sensint/Servo_Haptics/hardware/renders_images/hs2-render-1.png

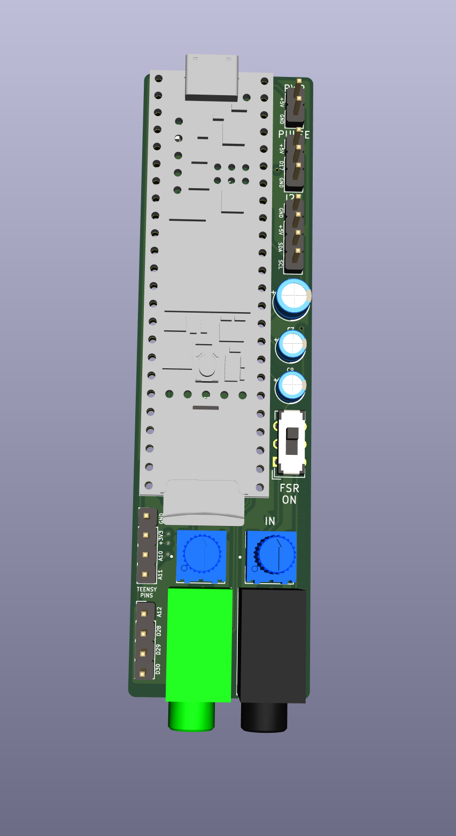
hardware/renders_images/hs2-render-1.png
