sensint/Servo_Haptics/hardware/renders_images/hs2-render-2.png

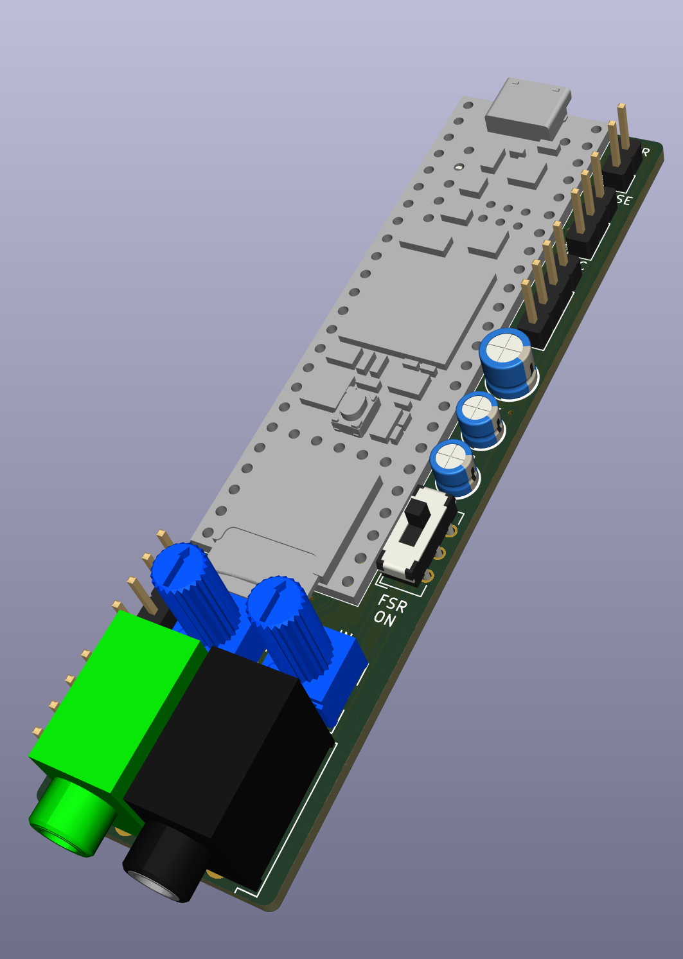
hardware/renders_images/hs2-render-2.png
