sensint/Servo_Haptics/hardware/renders_images/hs3-PCB.png

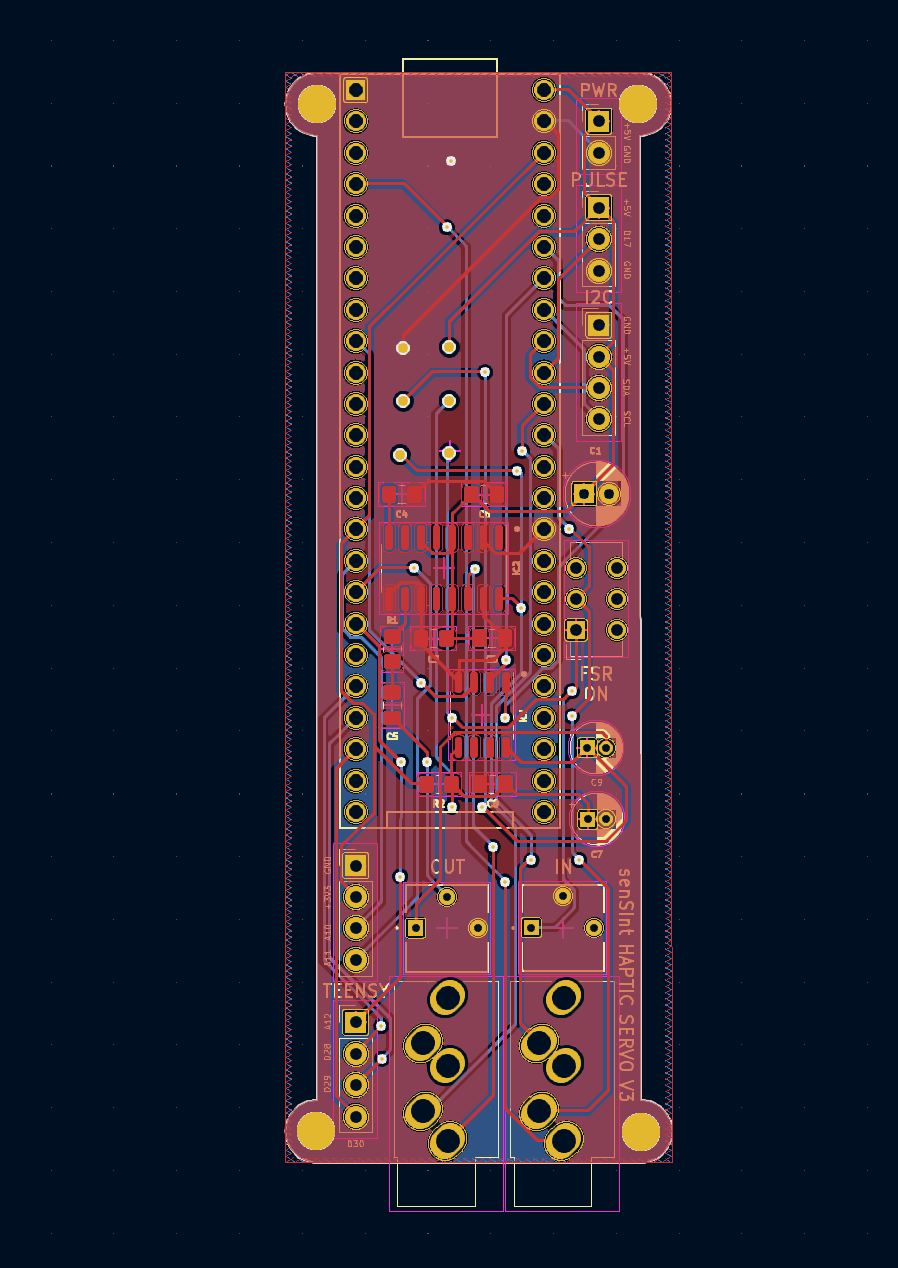
hardware/renders_images/hs3-PCB.png
