sensint/Servo_Haptics/hardware/renders_images/hs3-render-4.png

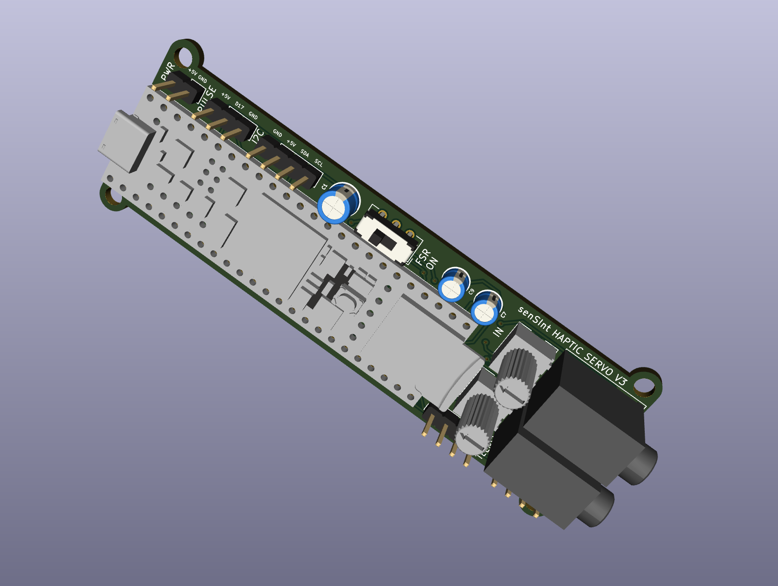
hardware/renders_images/hs3-render-4.png
