sensint/Servo_Haptics/hardware/Haptic_Servo_V3_BOM.xlsx

Haptic Servo
Teensy Shield BOM
Individual Components:
Reference(s) | Count | Value | LibPart | Footprint | Package | Product | Link
J4 | 1 |  | Connector:AudioJack3 | Connector_Audio:Jack_3.5mm_CUI_SJ1-3535NG_Horizontal | THT Tray | CUI Devices SJ1-3535NG-BE | https://www.digikey.de/de/products/detail/cui-devices/SJ1-3535NG-BE/2295992
J5 | 1 |  | Connector:AudioJack3 | Connector_Audio:Jack_3.5mm_CUI_SJ1-3535NG_Horizontal | THT Tray | CUI Devices SJ1-3535NG-PI | https://www.digikey.de/de/products/detail/cui-devices/SJ1-3535NG-PI/2295994
C4, 8 | 2 | 0.1 uF | Device:C | Capacitor_SMD:C_0805_2012Metric_Pad1.18x1.45mm_HandSolder | 805 | Kyocera AVX 08055C104KAT2A | https://www.digikey.de/en/products/detail/kyocera-avx/08055C104KAT2A/563505
C2, C3, C6 | 3 | 1 uF | Device:C | Capacitor_SMD:C_0805_2012Metric_Pad1.18x1.45mm_HandSolder | 805 | Kyocera AVX 08055C105KAT2A | https://www.digikey.de/en/products/detail/kyocera-avx/08055C105KAT2A/3081236
C5 | 1 | 0.47 uF | Device:C | Capacitor_SMD:C_0805_2012Metric_Pad1.18x1.45mm_HandSolder | 805 | Kyocera AVX 08055C474KAT2A | https://www.digikey.de/en/products/detail/kyocera-avx/08055C474KAT2A/1603015
C7, C9 | 2 | 47 uF | Device:C_Polarized_US | Capacitor_THT:CP_Radial_D4.0mm_P1.50mm | THT Bulk - 4mm dia, 1.5mm ls | Panasonic ECE-A0JKA470 | https://www.digikey.de/en/products/detail/panasonic-electronic-components/ECE-A0JKA470/6909
C1 | 1 | 470 uF | Device:C_Polarized_US | Capacitor_THT:CP_Radial_D5.0mm_P2.0mm | THT Bulk - 5mm dia, 2mm ls | Nichicon RF80E471MDN1JT | https://www.digikey.de/en/products/detail/nichicon/RF80E471MDN1JT/4991402
R2 | 1 | 10 ohm | Device:R | Resistor_SMD:R_0805_2012Metric_Pad1.20x1.40mm_HandSolder | 805 | Panasonic ERJ-6GEYJ100V | https://www.digikey.de/en/products/detail/panasonic-electronic-components/ERJ-6GEYJ100V/82966
R1 | 1 | 10K ohm | Device:R | Resistor_SMD:R_0805_2012Metric_Pad1.20x1.40mm_HandSolder | 805 | Panasonic ERA-6ARW103V | https://www.digikey.de/en/products/detail/panasonic-electronic-components/ERA-6ARW103V/3073782
IC2 | 1 |  | HapticServo:PAM8403 | Package_SO:SOIC-16_3.9x9.9mm_P1.27mm | SOP-16 | PAM8403 | https://www.mouser.de/ProductDetail/Diodes-Incorporated/PAM8403DR?qs=pYVYkI7xuRWy4KLk4EstIg%3D%3D
IC1 | 1 |  | HapticServo:PT8211 | Package_SO:SOP-8_3.9x4.9mm_P1.27mm | SOP-8 | PT8211 | https://www.ebay.de/itm/191674247950
U1 | 1 |  | HapticServo:TeensyHeader | HS-footprints:Teensy41 | board w/o headers | Teensy 4.1 | https://www.reichelt.com/de/en/teensy-4-1-usb-without-header-teensy-4-1-p283580.html?r=1
Already In Lab:
J1 | 1 | 1x2 | Connector_Generic:Conn_01x02 | Connector_PinHeader_2.54mm:PinHeader_1x02_P2.54mm_Vertical | 1x2 vertical header
J2 | 1 | 1x3 | Connector_Generic:Conn_01x03 | Connector_PinHeader_2.54mm:PinHeader_1x03_P2.54mm_Vertical | 1x3 vertical header
J3, J6, J7 | 3 | 1x4 | Connector_Generic:Conn_01x04 | Connector_PinHeader_2.54mm:PinHeader_1x04_P2.54mm_Vertical | 1x4 vertical header
RV1, RV2 | 2 | 50K ohm | Device:R_Potentiometer | Potentiometer_THT:Potentiometer_Runtron_RM-065_Vertical | THT Bulk - 6Runtron_RM-065 ote | RM-065
SW1 | 1 |  | Switch:SW_Push_DPDT | Button_Switch_THT:SW_CuK_JS202011CQN_DPDT_Straight | Switch_THT Bulk - 6CQN_DPDT W_C
Component Count: | 24
