sensint/Servo_Haptics/hardware/Haptic_Servo_V3/HS-footprints/teensy.pretty-master/Teensy_4.0_Assembly.STEP

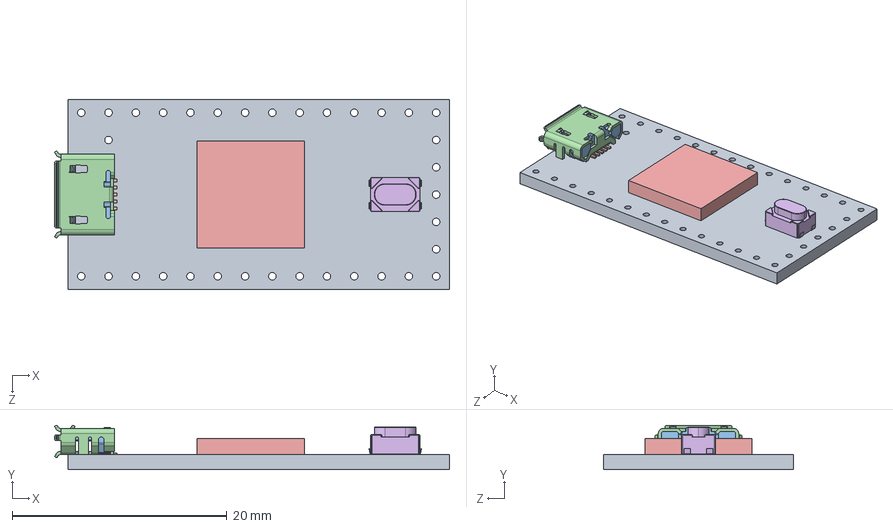
[picture p12: CAD file, 2022-09-22]
hardware/Haptic_Servo_V3/HS-footprints/teensy.pretty-master/Teensy_4.0_Assembly.STEP
36.8 x 4.12 x 17.7 mm
Teensy_4.0_PCB
Micro USB-B Female 5Pin SMD
NXP iMXRT1062
SKRPACE010 v4
