sensint/Servo_Haptics/hardware/Haptic_Servo_V3/HS-footprints/3362P-1-503TLF/3362P-1-503TLF.step

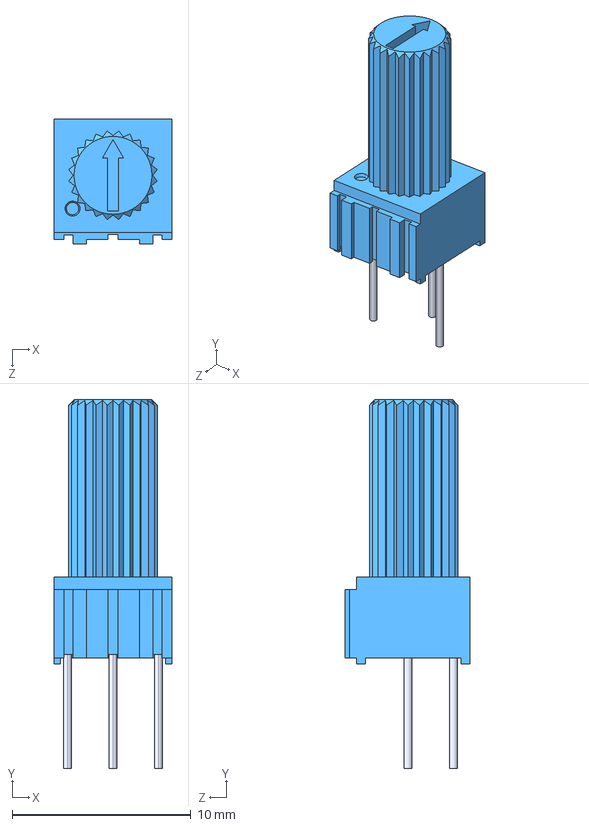
[picture p13: CAD file, 2022-09-22]
hardware/Haptic_Servo_V3/HS-footprints/3362P-1-503TLF/3362P-1-503TLF.step
6.60 x 20.7 x 6.99 mm
