sensint/Servo_Haptics/hardware/Haptic_Servo_V3/HS-footprints/CUI_DEVICES_SJ1-3533NG.step

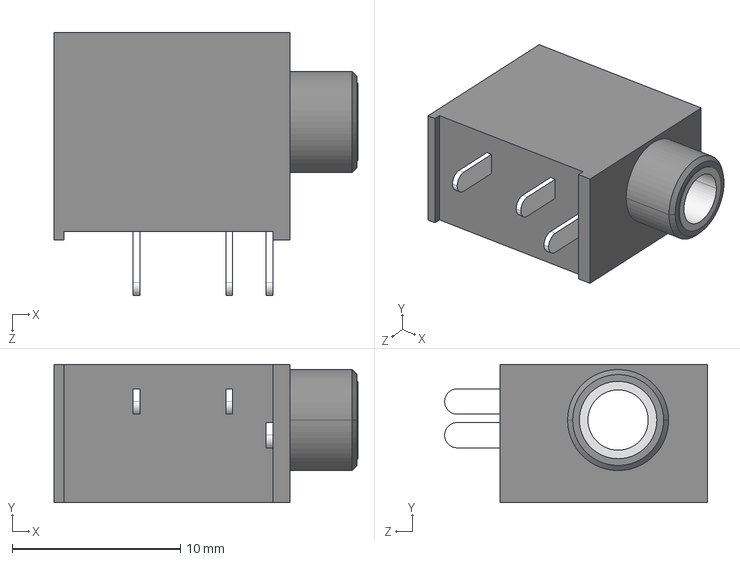
[picture p14: CAD file, 2022-09-22]
hardware/Haptic_Servo_V3/HS-footprints/CUI_DEVICES_SJ1-3533NG.step
18.1 x 8.20 x 15.6 mm
