sensint/Servo_Haptics/hardware/_archives/_OLDHapticServo-v1/IC_Diodes Inc._PAM8403DR/eec.models/Diodes_Inc._-_PAM8403DR.step

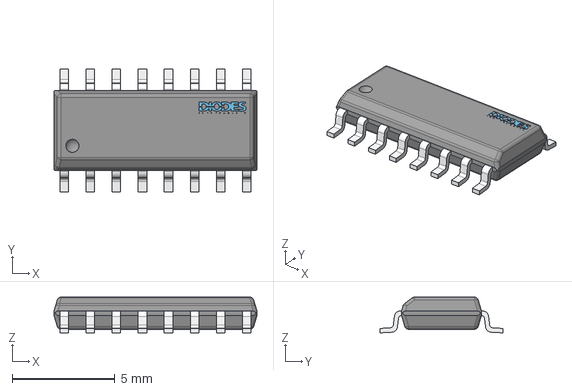
[picture p15: CAD file, 2022-09-22, an earlier design]
hardware/_archives/_OLDHapticServo-v1/IC_Diodes Inc._PAM8403DR/eec.models/Diodes_Inc._-_PAM8403DR.step
9.90 x 6.00 x 1.75 mm
