sensint/Servo_Haptics/CHANGELOG.md

# Changelog

## vX.Y.Z

### Added or Changed
- ...

### Removed

- ...
