sensint/Servo_Haptics/hardware/diagrams/Haptishield-v2-PCB.pdf

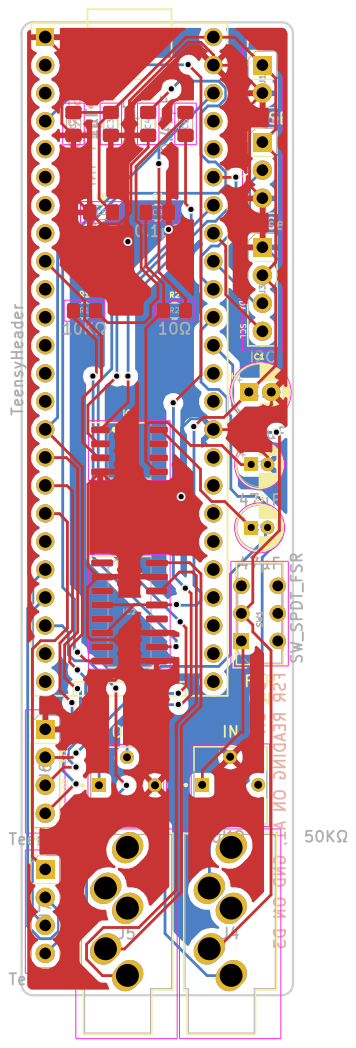
[picture p16: page 1]
