sensint/Servo_Haptics/hardware/diagrams/Haptishield-v2-schematic.pdf

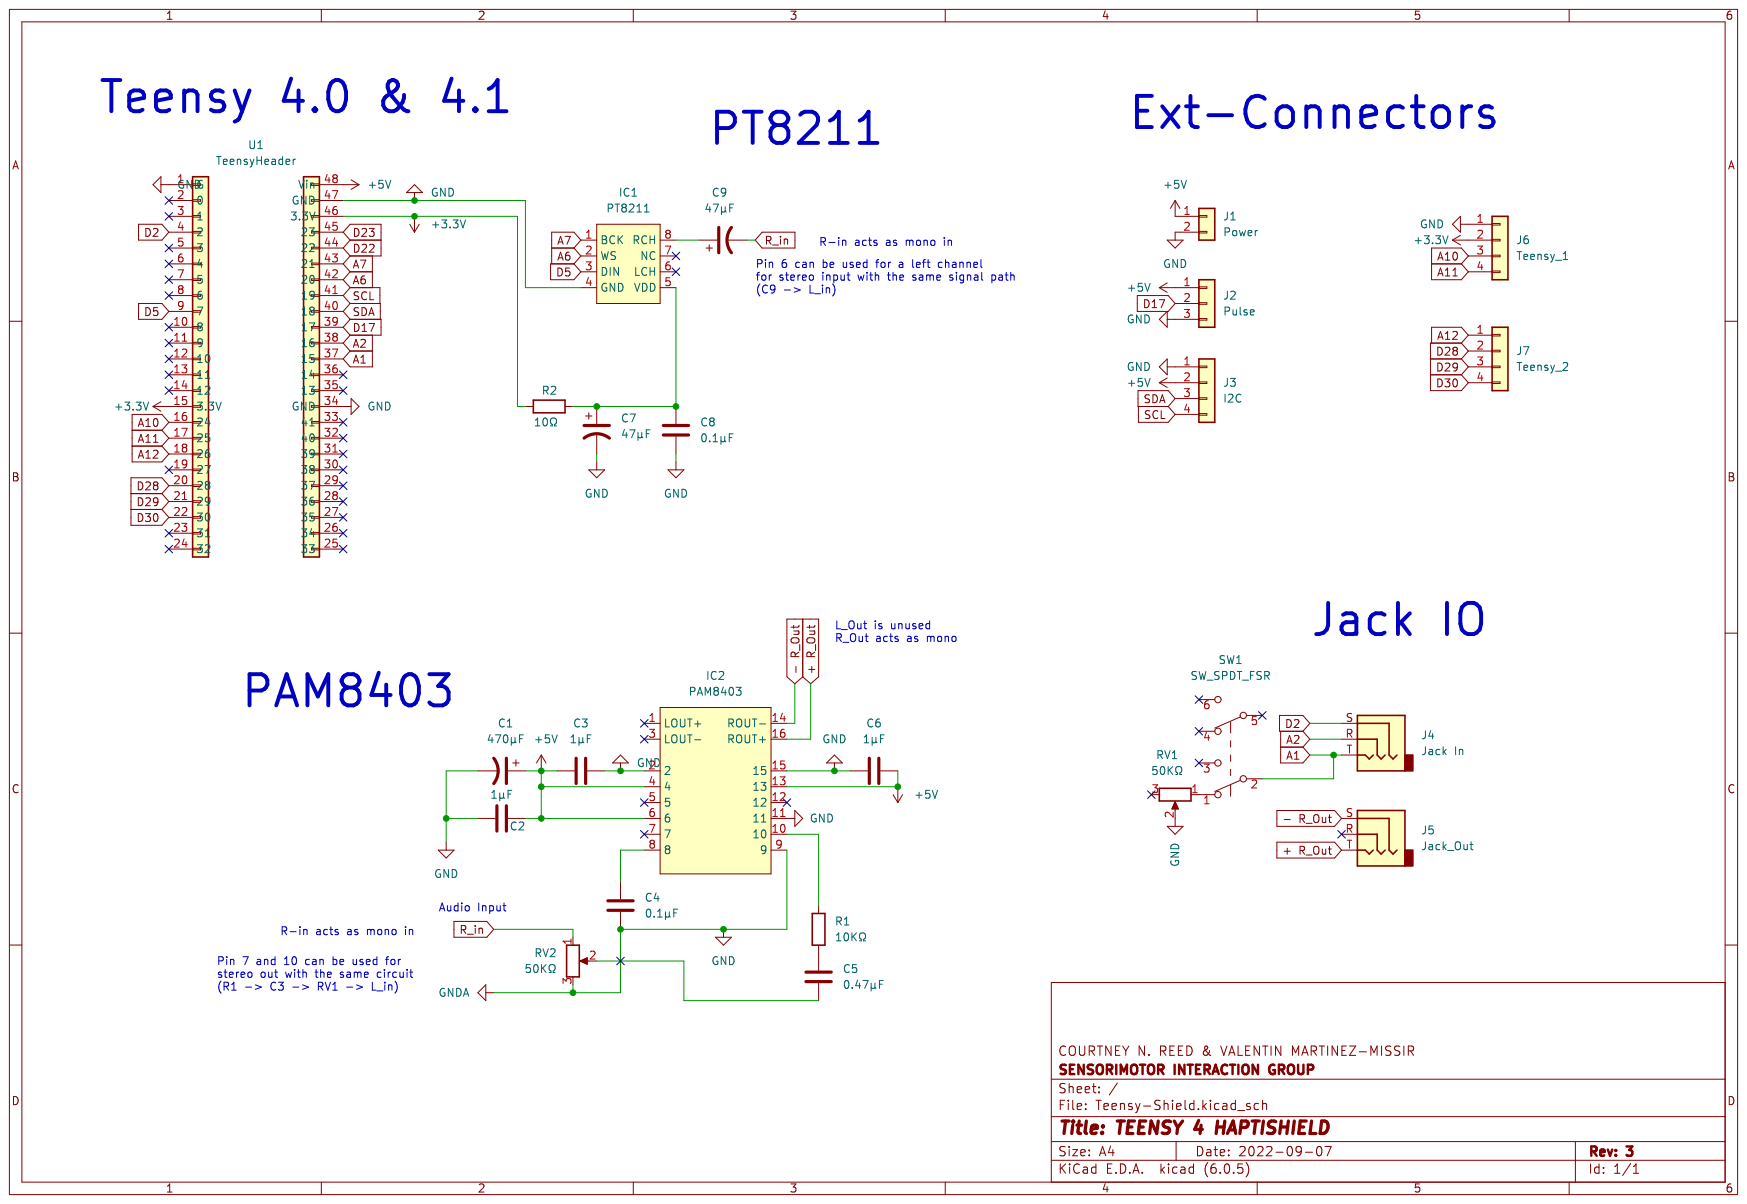
[picture p17: page 1]
