sensint/Servo_Haptics/hardware/_archives/_Haptishield-v2/Teensy-Shield.kicad_pcb

## KiCad design hardware/_archives/_Haptishield-v2/Teensy-Shield.kicad_pcb (2022-09-22, an earlier design)

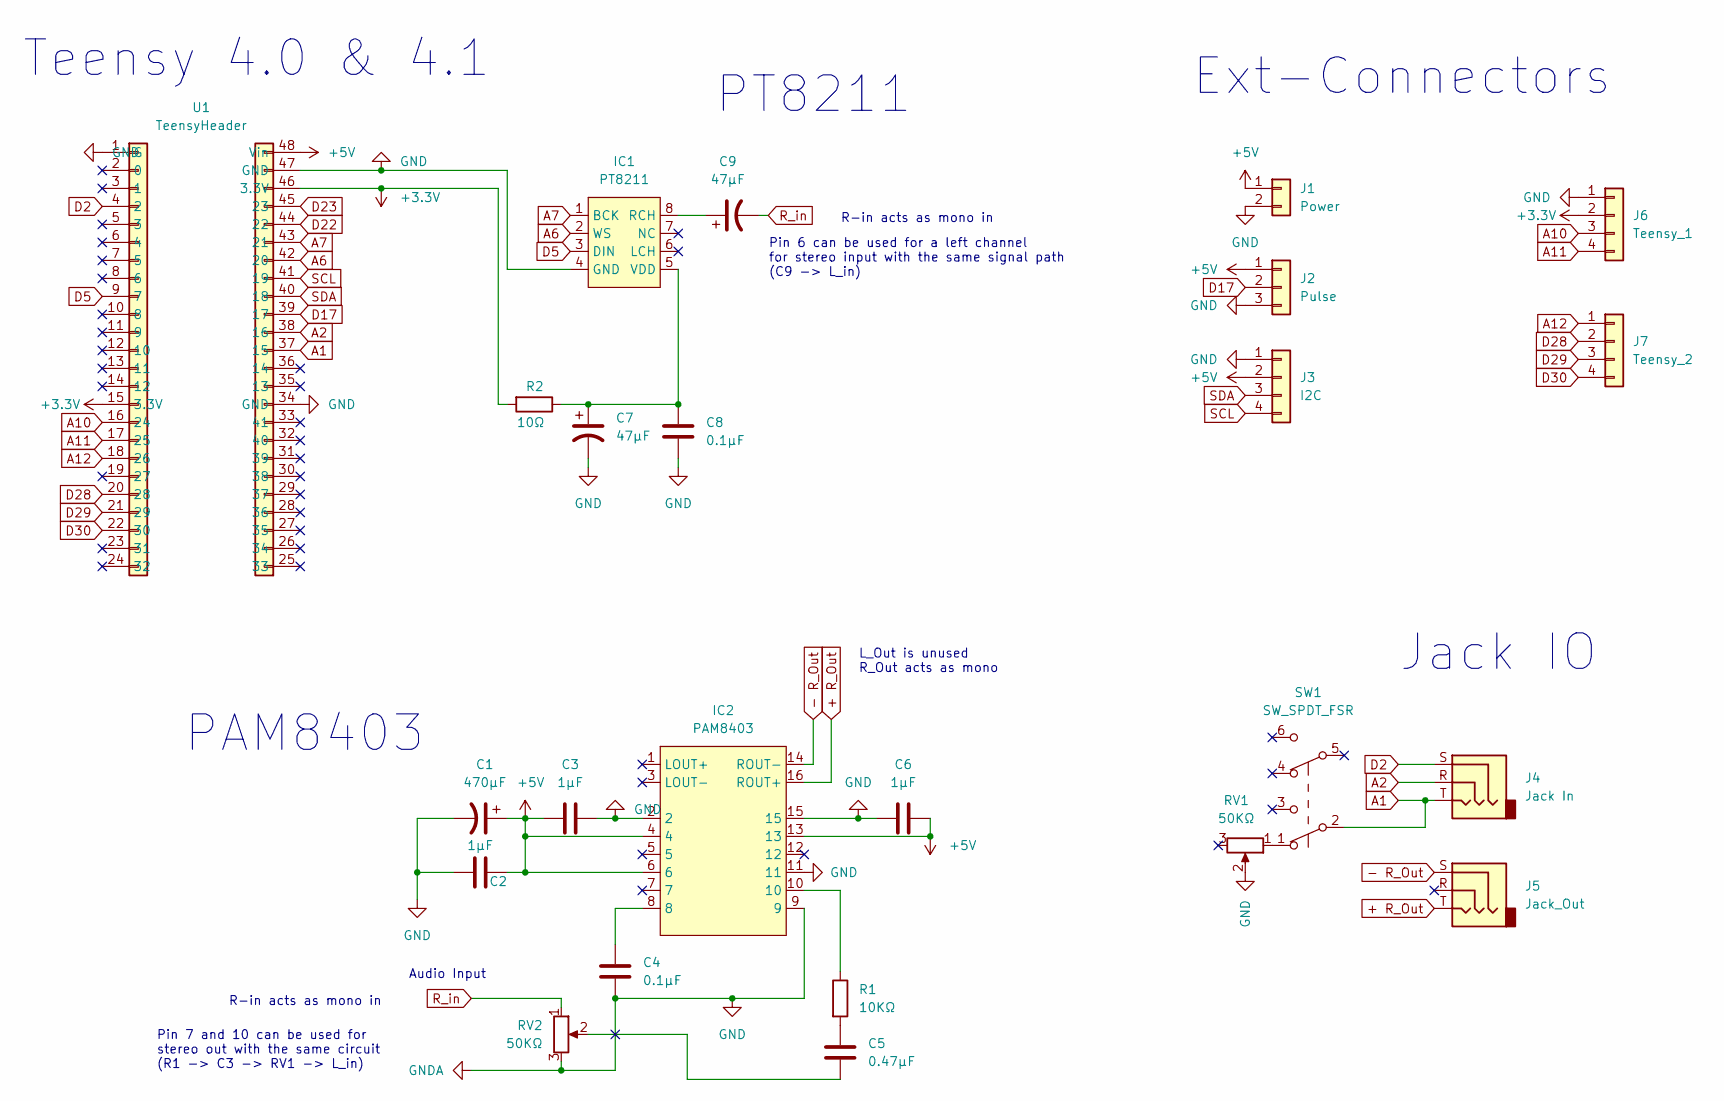
[picture p18: schematic Teensy-Shield.kicad_sch, TEENSY 4 HAPTISHIELD]

Parts:
C1: 470µF; CP_Radial_D5.0mm_P2.00mm
C2, C3, C6: 1µF; C_0805_2012Metric_Pad1.18x1.45mm_HandSolder
C4, C8: 0.1µF; C_0805_2012Metric_Pad1.18x1.45mm_HandSolder
C5: 0.47µF; C_0805_2012Metric_Pad1.18x1.45mm_HandSolder
C7, C9: 47µF; CP_Radial_D4.0mm_P1.50mm
IC1: PT8211; SOP-8_3.9x4.9mm_P1.27mm
IC2: PAM8403; SOIC-16_3.9x9.9mm_P1.27mm
J1: Power; PinHeader_1x02_P2.54mm_Vertical
J2: Pulse; PinHeader_1x03_P2.54mm_Vertical
J3: I2C; PinHeader_1x04_P2.54mm_Vertical
J4: Jack In; Jack_3.5mm_CUI_SJ1-3535NG_Horizontal_CircularHoles
J5: Jack_Out; Jack_3.5mm_CUI_SJ1-3535NG_Horizontal_CircularHoles
J6: Teensy_1; PinHeader_1x04_P2.54mm_Vertical
J7: Teensy_2; PinHeader_1x04_P2.54mm_Vertical
R1: 10KΩ; R_0805_2012Metric_Pad1.20x1.40mm_HandSolder
R2: 10Ω; R_0805_2012Metric_Pad1.20x1.40mm_HandSolder
RV1, RV2: 50KΩ; TRIM_3362P-1-503TLF
SW1: SW_SPDT_FSR; SW_CuK_JS202011CQN_DPDT_Straight
U1: TeensyHeader; Teensy41

Connections:
+3V3: J6.2, R2.2, U1.15 (3.3V), U1.46 (3.3V)
+5V: C1.1, C2.2, C3.1, C6.2, IC2.4, IC2.6, IC2.13, J1.1, J2.1, J3.2, U1.48 (Vin)
+ R_Out: IC2.16 (ROUT+), J5.T
- R_Out: IC2.14 (ROUT-), J5.S
A1: J4.T, SW1.2 (B), U1.37 (15)
A2: J4.R, U1.38 (16)
A6: IC1.2 (WS), U1.42 (20)
A7: IC1.1 (BCK), U1.43 (21)
A10: J6.3, U1.16 (24)
A11: J6.4, U1.17 (25)
A12: J7.1, U1.18 (26)
D2: J4.S, U1.4 (2)
D5: IC1.3 (DIN), U1.9 (7)
D17: J2.2, U1.39 (17)
D22: U1.44 (22)
D23: U1.45 (23)
D28: J7.2, U1.20 (28)
D29: J7.3, U1.21 (29)
D30: J7.4, U1.22 (30)
GND: C1.2, C2.1, C3.2, C4.2, C6.1, C7.2, C8.2, IC1.4 (GND), IC2.2, IC2.9, IC2.11, IC2.15, J1.2, J2.3, J3.1, J6.1, RV1.2, RV2.3, U1.1 (G), U1.34 (GND), U1.47 (GND)
unnamed: C4.1, IC2.8
unnamed: C5.1, R1.2
unnamed: C5.2, RV2.2
unnamed: C7.1, C8.1, IC1.5 (VDD), R2.1
unnamed: C9.1, IC1.8 (RCH)
unnamed: IC2.10, R1.1
unnamed: RV1.1, SW1.1 (A)
R_in: C9.2, RV2.1
SCL: J3.4, U1.41 (19)
SDA: J3.3, U1.40 (18)

Notes on the sheet:
Jack IO
R-in acts as mono in
Pin 7 and 10 can be used for stereo out with the same circuit (R1 -> C3 -> RV1 -> L_in)
Audio Input
PAM8403
PT8211
Pin 6 can be used for a left channel for stereo input with the same signal path (C9 -> L_in)
Ext-Connectors
Teensy 4.0 & 4.1
L_Out is unused R_Out acts as mono

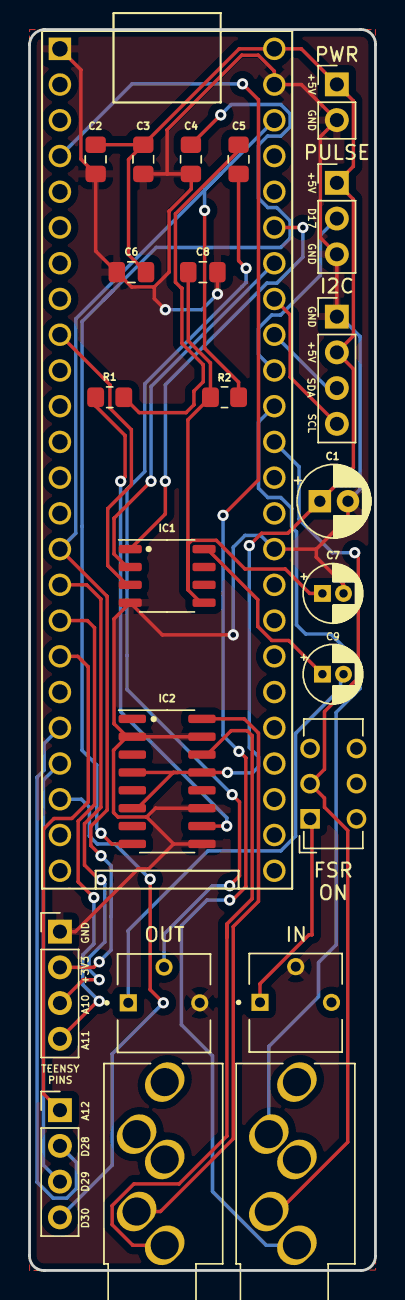
[picture p19: board Teensy-Shield.kicad_pcb from above]

Board: 2 copper layers, 24.6 x 88.2 mm, 24 parts (0 on the bottom side), 28 nets.
