sensint/Servo_Haptics/firmware/Teensyduino/Benchmark/Benchmark.ino

/* This sketch is used to measure the latency of a ServoHaptic
 * controller. Here, (electrical) latency is defined by the duration
 * from a sensor input to the signal output at the DAC.
 * 
 *    BENCHMARK-controller             ServoHaptics-controller
 *    ====================             =======================
 *    
 *    common ground :: GND o---------o GND :: common ground
 *    trigger out   ::   2 ---------->  A0 :: sensor input
 *    trigger in    ::   3 <----------   8 :: benchmark out
 *    measure       ::  A2 <---------- DAC :: signal output
 * 
 * !!! CAUTION !!!
 * DO NOT DIRECTLY CONNECT THE DAC OUTPUT TO THE ANALOG INPUT UNLESS
 * YOU REDUCED THE OUTPUT LEVEL OF THE AUDIO SHIELD. THE MAXIMUM
 * NEGATIVE VOLTAGE SHOULD BE BELOW 500mV. MORE DETAILS ARE GIVEN BELOW
 * FOR THE CALCULATION OF THE MEASUREMENT THRESHOLD.
 */


/* If USE_MICROS is defined the firmware uses the micros() function
 * to measure the time. If it's undefined (i.e. commented out) the
 * firmware uses clock cycles. NOTE, to convert cycles into time you
 * need to know the clock speed of your processor, e.g.
 *  - Teensy3.5: 120MHz (120 cycles per microsecond)
 *  - Teensy4.1: 600MHz (600 cycles per microsecond)
 */
#define USE_MICROS

namespace {
  /* This pin is connected to the ServoHaptic controller's sensor input.
   * Setting it HIGH will trigger the ServoHaptic controller to start a pulse.
   */
  constexpr uint8_t kTriggerOutPin = 2;
  bool is_high = false;
  
  /* This pin is connected to the ServoHaptic controller's benchmark pin.
   * It will be set HIGH for the duration of the pulse.
   */
  constexpr uint8_t kTriggerInPin = 3;

  /* This pin is connected to the ServoHaptic controller's DAC output.
   * To reduce latency due to the signal you might use a square waveform.
   */
  constexpr uint8_t kMeasurePin = A2;

  /* Set the resolution (bit depth) for the analogRead function.
   */
  constexpr uint8_t kMeasureResolution = 10;
  constexpr uint32_t kMeasureMaxValue = (1U << kMeasureResolution) - 1;
  
  /* The PT8211 outputs an AC signal. To prevent the analog input pin from any
   * damage, we reduce the DAC's output level by setting a low amplitude (0.2f).
   * This gives a peak-to-peak voltage (Vpp) of 0.32V and Vrms = 0.16V. Hence, the 
   * Vrms is the maximum voltage which one could measure with the analogRead function.
   * Vrel = Vrms / Vref --> 0.16 / 3.3 = 0.048 (0.05)
   * So for a 10bit range (0-1023) the maximum value will be ~50 (1024*0.05).
   * To account for inaccuracies we lower the threshold a little bit (e.g. 0.04).
   */
  constexpr uint32_t kMeasureThreshold = kMeasureMaxValue * 0.04;

  /* The benchmark will run in a given amount of iterations.
   * Afterwards it stops (enters inifinite loop).
   */
  constexpr uint32_t kIterations = 1000;
  uint32_t iteration = 0;
  
  // each iteration pauses for a given duration (blocking)
  constexpr uint32_t kTriggerDelayMinMs = 1;
  constexpr uint32_t kTriggerDelayMaxMs = 100;
}

void setup() {
  while (!Serial && millis() < 5000) ;
  Serial.begin(115200);
    
  pinMode(kTriggerOutPin, OUTPUT);
  pinMode(kTriggerInPin, INPUT_PULLDOWN);
  pinMode(kMeasurePin, INPUT_PULLDOWN);
  analogReadRes(kMeasureResolution);

  digitalWriteFast(kTriggerOutPin, LOW);

  Serial.println("Benchmark");
#ifdef USE_MICROS
  Serial.println(" >>> time measurement in microseconds");
#else
  Serial.println(" >>> time measurement in clock cycles");
#endif
}

void loop() {
  
  if (iteration < kIterations) {
    is_high = !is_high; 
    /* Toggle the pin from LOW to HIGH and vice versa to
     * trigger the ServoHaptic controller's sensor input.
     * Each trigger will 
     */
    digitalWriteFast(kTriggerOutPin, is_high);

    /* Start the time measurement.
     */
#ifdef USE_MICROS
    uint32_t time = micros();
#else
    uint32_t cycles = ARM_DWT_CYCCNT;
#endif

    /* Wait for the signal from the ServoHaptic controller's DAC output
     * to go HIGH. Since the output is an analog signal it maybe has some
     * latency to reach the HIGH-threshold voltage. You can try to reduce
     * this latency by using a square wave.
     */
    while (analogRead(kMeasurePin) < kMeasureThreshold) ;

    /* Stop the time measurement as soon as the signal was recognized.
     */
#ifdef USE_MICROS
    uint32_t delta_time = micros() - time - 7;
#else
    uint32_t delta_cycles = ARM_DWT_CYCCNT - cycles - 2;
#endif

    /* Write result of this iteration to the serial port.
     */
#ifdef USE_MICROS
    Serial.print(delta_time);
#else
    Serial.print(delta_cycles);
#endif
    Serial.print(',');

    /* Wait for ServoHaptic controller to finish the pulse (i.e. go to LOW). 
     */
    while (digitalReadFast(kTriggerInPin)) ;

    /* Wait a given time before we start the next iteration.
     * We randomize the delay to account for unknown side effects.
     */
    delay(random(kTriggerDelayMinMs,kTriggerDelayMaxMs));
    
    iteration++;
  } else {
    /* After running all iterations the firmware will stop, i.e. enter an infinite loop.
     */
    Serial.printf("\n >>> Finished benchmark with %d iterations.\n", (int)kIterations);
    while (true) ;
  }
}
