sensint/Servo_Haptics/(commit log)

2022-03-22 feat: :sparkles: port for PlatformIO
    This commit adds the project setup for PlatformIO based on the Teensyduino code.
2022-03-25 fix: :bug: number of bins needs to be one less
    We use the number of bins to retrieve the current bin number. Since the first bin has the id 0 we need to reduce the value by one.
    [settings.h]
2022-03-25 refactor: :construction: finished benchmarking the electrical latency
    We measured the electrical latency of the system, i.e. the time from triggering a sensor to the start of the audio signal. This is measured at the output of the DAC.
2022-03-28 fix: :bug: reset waveform at pulse start
    To start a new pulse we need to first set the correct amplitude and then restart the waveform.
    [main.cpp]
2022-03-28 fix: :bug: force inlining of functions
    [main.cpp]
2022-03-29 feat: :sparkles: read servo signals
    We provide a easy to use interface based on the Servo library to simplify the design process of motion coupled vibration. Therefore, we provide predefined lookup tables of signal parameters one could cycles through by sending servo angles in form of variable pulse lengths.
    [config.h, main.cpp, settings.h]
2022-03-30 fix: :bug: initialize servo pin
    [config.h]
2022-03-30 refactor: :construction: change servo pin
2022-03-31 fix: :bug: slowed down reading a servo with interrupts and timer
    [config.h, main.cpp, settings.h]
2022-03-31 feat: :sparkles: demo of a Haptic Servo
2022-03-31 feat: :rocket: port firmware to Teensyduino
2022-07-05 CAD resources to hardware
    [Diodes_Inc._-_PAM8403DR.step, HapticServo-v1.kicad_pcb, HapticServo-v1.sch]
2022-09-22 HS Haptishield v2 files and schematics added
    [3362P-1-103TLF--3DModel-STEP-56544.STEP, 3362P-1-503TLF.step, CUI_DEVICES_SJ1-3533NG.step, Diodes_Inc._-_PAM8403DR.step, HapticServo-v1.kicad_pcb, HapticServo-v1.sch, Teensy-Shield.kicad_pcb, Teensy-Shield.kicad_sch]
2022-11-15 Reason for hardware fix- Pin 2 Low
    Creating a virtual ground.
    [HapticServo.ino]
2023-11-27 Add Haptic Servo V3 CAD and BOM
    [3362P-1-103TLF--3DModel-STEP-56544.STEP, 3362P-1-503TLF.step, CUI_DEVICES_SJ1-3533NG.step, Haptic_Servo_V3.kicad_pcb, Haptic_Servo_V3.kicad_sch, Haptic_Servo_V3_BOM.xlsx, Teensy-Shield.kicad_pcb, Teensy-Shield.kicad_sch]
